MelansonTech/Speaker-Module/Photos/20240408_120147.jpg

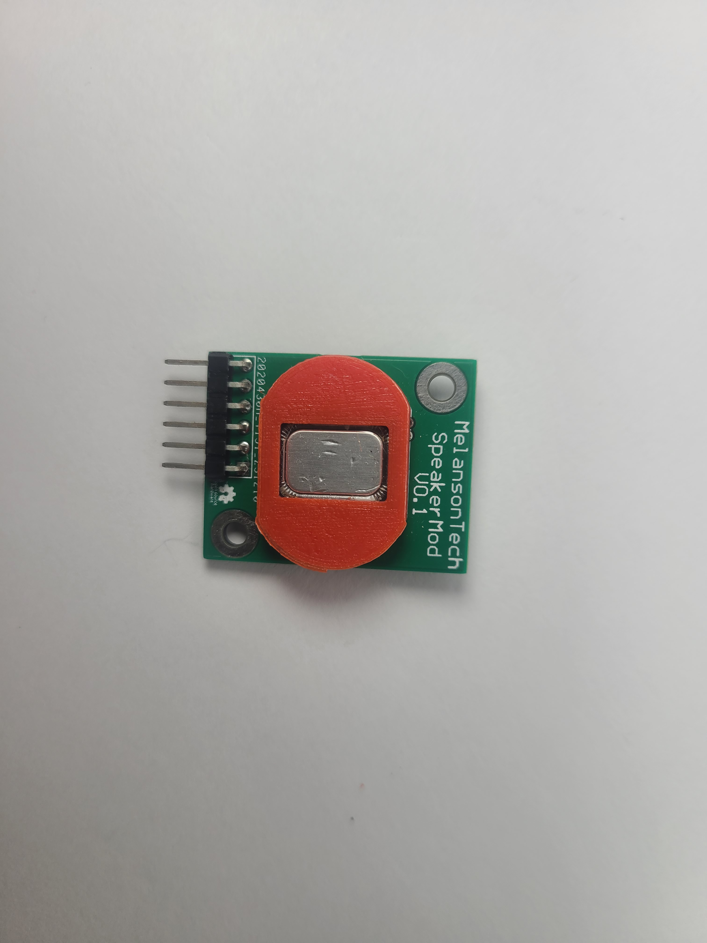
Photos/20240408_120147.jpg
