MelansonTech/Speaker-Module/Photos/20240408_120144.jpg

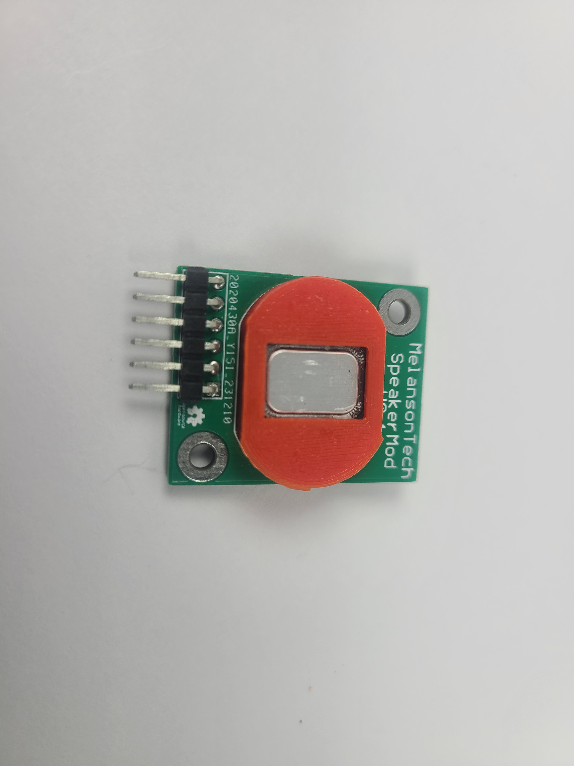
Photos/20240408_120144.jpg
