MelansonTech/Speaker-Module/Project description for speaker module.docx

### Project Title: Mini Speaker Module with IS31AP4991A Audio Driver

#### Overview:

Developed a compact 700mW mini speaker module featuring the CMS-15113-076S speaker and integrated audio driver IS31AP4991A-GRLS2-TR. The project aimed to deliver high-quality audio output in a small form factor with a focus on power efficiency.

#### Project Objectives:

1. Objective 1: Design a mini speaker module with a power output of 700mW.
2. Objective 2: Integrate the CMS-15113-076S speaker for optimal audio performance.
3. Objective 3: Implement the IS31AP4991A-GRLS2-TR audio driver with a gain of 2 and shutdown functionality.
4. Objective 4: Achieve compact dimensions of 33mm by 26mm for the entire module.

#### Role and Responsibilities:

As the lead hardware designer:

- Conducted a comprehensive market analysis to select the CMS-15113-076S speaker and IS31AP4991A-GRLS2-TR audio driver.
- Developed the schematic design using Circuit Studio, considering power requirements, speaker specifications, and audio driver features.
- Utilized LTspice for circuit analysis during the design phase.
- Oversaw the prototyping phase, addressing challenges in component placement and optimizing the layout for the compact form factor.
- Implemented rigorous testing procedures to ensure the module met power output specifications and delivered clear audio signals.

#### Design Process:

1. Conceptualization: Started with a detailed analysis of speaker and audio driver options, considering power requirements and form factor constraints.
2. Schematic Design: Developed a schematic using Circuit Studio, integrating the CMS-15113-076S speaker and IS31AP4991A-GRLS2-TR audio driver with a focus on efficient power utilization.
3. Prototyping: Executed multiple prototypes, refining the layout for optimal signal integrity and minimizing interference.
4. Testing and Validation: Conducted extensive testing to verify the 700mW power output, audio quality, and shutdown functionality of the module.

#### Key Features:

1. High Power Output: Achieved a 700mW power output for clear and loud audio playback.
2. Compact Form Factor: Designed the module with dimensions of 33mm by 26mm, making it suitable for space-constrained applications.
3. Integrated Audio Driver: Utilized the IS31AP4991A-GRLS2-TR audio driver with a gain of 2 and shutdown functionality for efficient power management.

#### Tools and Technologies:

1. Design Software: Utilized Circuit Studio for schematic design and layout.
2. Simulation Software: Employed LTspice for circuit analysis.
3. Testing Equipment: Used oscilloscope and multimeter for signal verification and power measurements.

#### Results and Achievements:

The mini speaker module successfully met and exceeded the project objectives, delivering a powerful audio output in a compact form factor. The integrated audio driver ensured efficient power management, and the module proved to be reliable and robust in various testing scenarios.

#### Lessons Learned:

The project provided valuable insights into optimizing component placement for compact designs and balancing power efficiency with audio performance. Future iterations could explore additional features while maintaining the small footprint.

#### Conclusion:

The completion of the mini speaker module project demonstrates a successful integration of the CMS-15113-076S speaker and IS31AP4991A-GRLS2-TR audio driver, showcasing expertise in hardware design, compact layout, and power management.

#### Additional Resources:

- Link to Datasheet: CMS-15113-076S Speaker
- Link to Datasheet: IS31AP4991A-GRLS2-TR Audio Driver
