MelansonTech/Speaker-Module/Photos/20240408_120136.jpg

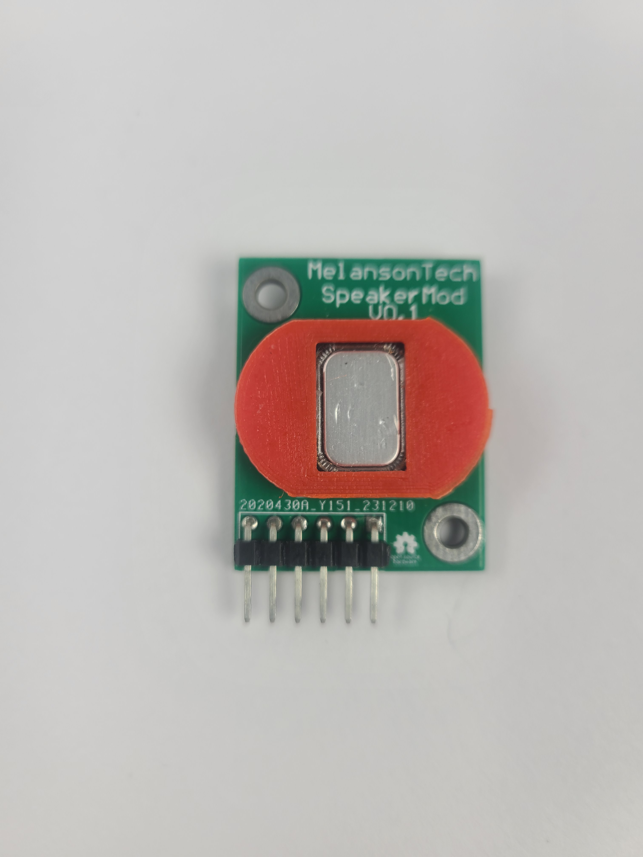
Photos/20240408_120136.jpg
