MelansonTech/Speaker-Module/Photos/20240408_120201.jpg

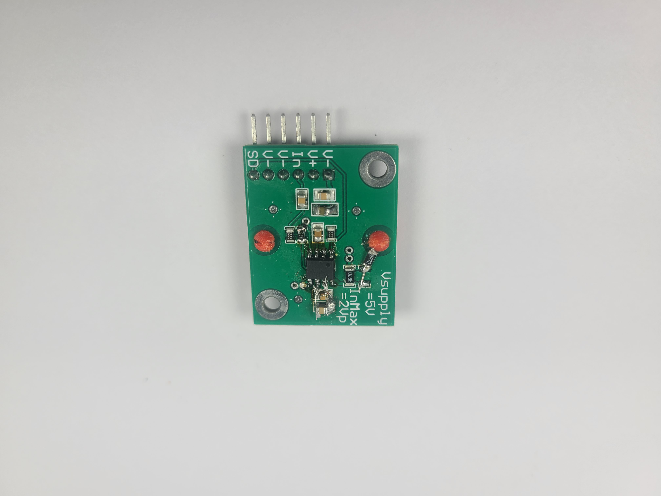
Photos/20240408_120201.jpg
