MelansonTech/Speaker-Module/Default Configuration/Outputs/BOM/BOM_PartType-Speaker Module Rev 2.xls

Sheet: BOM Report
Bill of Materials |  |  | <Parameter Title not found>
Source Data From: |  | Speaker Module Rev 2.PrjPcb
Project: |  | Speaker Module Rev 2.PrjPcb
Variant: |  | None
Creation Date: | 12/27/2023 | 3:08:30 PM
Print Date: | 2023-12-27 | 15:08:53
Production Quantity: | 1
Currency | CAD
Footprint | Comment | LibRef | Designator | Description | Quantity | Supplier 1 | Supplier Part Number 1 | Supplier Unit Price 1 | Supplier Order Qty 1 | Supplier Subtotal 1 | Manufacturer 1 | Manufacturer Part Number 1
Cap,0805 | 08055C104JAT2A | Cap,0805,100nf,50V,5%,08055C104JAT2A | C1, C4, C5 | Capacitor; Ceramic; Cap 0.1 uF; Tol 5%; Vol-Rtg 50 VDC; SMT; 0805; X7R; Tape & Reel | 3 | Digi-Key | 478-3352-1-ND |  |  |  | Loading... | Loading...
CAP, 0805, HD | AVX 08053C225KAT2A | Cap,0805,2.2uF,±10%,25V,08053C225KAT2A | C2 | 0805 2.2 uF 25 V ±10 % Tolerance X7R SMT Multilayer Ceramic Capacitor | 1 | Digi-Key | 478-5719-1-ND |  |  |  | Kyocera AVX | KGM21AR71E225KU
Cap,0805 | CGA4J2X7R1E474K125AA | Cap,0805,470nf,25V,10%,CGA4J2X7R1E474K125AA | C3 | 0.47µF ±10% 25V Ceramic Capacitor X7R 0805 (2012 Metric) | 1 | Digi-Key | 445-5685-1-ND | 0.3052 | 1 | $0.31 | TDK | CGA4J2X7R1E474K125AA
Cap, 1206 | C3216X7R1E106K160AB | CAP,1206,10uF,25V,C3216X7R1E106K160AB | C6 | 10µF ±10% 25V Ceramic Capacitor X7R 1206 (3216 Metric) | 1 | Digi-Key | 445-7705-1-ND |  |  |  | Loading... | Loading...
FIDU-ROUND | Mech,FIDU-ROUND | Mech,FIDU-ROUND | FD1, FD2, FD3 | ROUND FIDUCIAL | 3
Header, 6 pin, 0.1" Spaceing - RA | Header, through hole,vertical, 6pin,1 Row,0.1", M20-9991245 | Header, through hole,vertical, 6pin,1 Row,0.1", M20-9991245 | J1 | 2.54mm (0.1") Pitch SIL Vertical PC Tail Pin Header, 6.1mm mating pin height, gold (hi-temp mould), 6 contacts | 1 | Digi-Key
Symbol,Open Source | Open Source Logo | Symbol,Open Source | Logo1 | Open Source Silk Screen Logo | 1
Standoff,Hex,M3,8mm | M3 hex Standoff | Mech,Standoff, M3, Hex | M1, M2 | HEX STANDOFF M3,generic | 2 | Digi-Key | 36-24314-ND | 1.34797 | 2 | $2.70 | Keystone Electronics | 24314
res, 0805, HD | RC0805FR-0722K1L | Res,0805,22.1K,1%,100ppm,RC0805FR-0722K1L | R1, R4 | 22.1 kOhms ±1% 0.125W, 1/8W Chip Resistor 0805 (2012 Metric) Moisture Resistant Thick Film | 2 | Digi-Key | 311-22.1KCRCT-ND | 0.12717 | 2 | $0.25 | Yageo | RC0805FR-0722K1L
Res,1206 | 4.7O | Res,1206,Generic | R2, R3 |  | 2
res, 0805, HD | RK73H2ATTD4752F | Res,0805,47.5KO,1%,100ppm,RK73H2ATTD4752F | R5 | 47.5 kOhms ±1% 0.25W, 1/4W Chip Resistor 0805 (2012 Metric) Automotive AEC-Q200, Moisture Resistant Thick Film | 1 | Digi-Key | 2019-RK73H2ATTD4752FCT-ND | 0.12717 | 1 | $0.13 | KOA Speer | RK73H2ATTD4752F
Speaker,SMD,CMS-15113-076S | CMS-15113-076S | Speaker,SMD,6O,700mW,Magnetic,100 Hz ~ 20 kHz,CMS-15113-076S | Speaker1 | 6 Ohms General Purpose Speaker 700 mW 100 Hz ~ 20 kHz Top Rectangular | 1
SOIC-8 | IS31AP4991A-GRLS2-TR | IC,PowerAmp,ClassAB,1.15W x 1 @ 8Ohm,2.7V ~ 5.5V,IS31AP4991 | U1 | IC AMP CLASS AB MONO 1.15W 8SOIC | 1 | Mouser | 870-I31AP4991AGRLS2T | 0.72485 | 1 | $0.72 | ISSI | IS31AP4991A-GRLS2-TR
 |  |  |  |  | 20 |  |  |  |  | $4.11
Approved |  | Notes

Sheet: Project Information
Project Full Path | E:\OneDrive\Shawn\circuitstudio projects\Speaker Module\Speaker Module Rev 2.PrjPcb
Project Filename | Speaker Module Rev 2.PrjPcb
Variant Name | None
Data-Source Filename | Speaker Module Rev 2.PrjPcb
Data-Source Full Path | E:\OneDrive\Shawn\circuitstudio projects\Speaker Module\Speaker Module Rev 2.PrjPcb
Title | <Parameter Title not found>
Total Quantity | 20
Report Time | 3:08:30 PM
Report Date | 12/27/2023
Report Date & Tine | 12/27/2023 3:08:30 PM
Output Name | BOM_PartType
Output Type | BOM_PartType
Output Generator Name | BOM
Output Generator Description | Bill of Materials
