MelansonTech/Speaker-Module/Default Configuration/Outputs/JLC Order Info/Speaker Module Rev 1_JLC_BOM Rev 1.xlsx

Comment | Designator | Footprint | LCSC Part #（optional）
100nF 0805 | C1, C4, C5 | 0805_C | C49678
Cap,0805,2.2uF,±10%,25V,08053C225KAT2A | C2 | 0805_C | C377773
Cap,0805,470nf,25V,10%,CGA4J2X7R1E474K125AA | C3 | 0805_C | C13967
CAP,1206,10uF,25V,C3216X7R1E106K160AB | C6 | 1206_C | C13585
Res,0805,22.1K,1%,100ppm,RC0805FR-0722K1L | R1, R4, R5 | 0805_R | C17560
