MelansonTech/Speaker-Module/Default Configuration/Outputs/Speaker module Rev 1 Sept 2022/BOM_PartType-Speaker Module.xls

Sheet: BOM Report
Bill of Materials |  |  | <Parameter Title not found>
Source Data From: |  | Speaker Module.PrjPcb
Project: |  | Speaker Module.PrjPcb
Variant: |  | None
Creation Date: | 9/18/2022 | 9:58:10 PM
Print Date: | 2022-09-18 | 21:58:31
Production Quantity: | 1
Currency | CAD
Footprint | Comment | LibRef | Designator | Description | Quantity | Supplier 1 | Supplier Part Number 1 | Supplier Unit Price 1 | Supplier Order Qty 1 | Supplier Subtotal 1 | Manufacturer 1 | Manufacturer Part Number 1
Cap,0805 | 08055C104JAT2A | Cap,0805,100nf,50V,5%,08055C104JAT2A | C1, C4, C5 | Capacitor; Ceramic; Cap 0.1 uF; Tol 5%; Vol-Rtg 50 VDC; SMT; 0805; X7R; Tape & Reel | 3 | Digi-Key | 478-3352-1-ND | 0.1526 | 3 | $0.46 | Kyocera AVX | 08055C104JAT2A
CAP, 0805, HD | AVX 08053C225KAT2A | Cap,0805,2.2uF,±10%,25V,08053C225KAT2A | C2 | 0805 2.2 uF 25 V ±10 % Tolerance X7R SMT Multilayer Ceramic Capacitor | 1 | Digi-Key | 478-5719-1-ND | 0.3815 | 1 | $0.38 | Kyocera AVX | 08053C225KAT2A
Cap,0805 | CGA4J2X7R1E474K125AA | Cap,0805,470nf,25V,10%,CGA4J2X7R1E474K125AA | C3 | 0.47µF ±10% 25V Ceramic Capacitor X7R 0805 (2012 Metric) | 1 | Digi-Key | 445-5685-1-ND | 0.3052 | 1 | $0.31 | TDK | CGA4J2X7R1E474K125AA
Cap, 1206 | C3216X7R1E106K160AB | CAP,1206,10uF,25V,C3216X7R1E106K160AB | C6 | 10µF ±10% 25V Ceramic Capacitor X7R 1206 (3216 Metric) | 1 | Digi-Key | 445-7705-1-ND |  |  |  | TDK | C3216X7R1E106K160AB
FIDU-ROUND | Mech,FIDU-ROUND | Mech,FIDU-ROUND | FD1, FD2, FD3 | ROUND FIDUCIAL | 3
Header, 6 pin, 0.1" Spaceing - RA | Header, through hole,vertical, 6pin,1 Row,0.1", M20-9991245 | Header, through hole,vertical, 6pin,1 Row,0.1", M20-9991245 | J1 | 2.54mm (0.1") Pitch SIL Vertical PC Tail Pin Header, 6.1mm mating pin height, gold (hi-temp mould), 6 contacts | 1 | Digi-Key
Symbol,Open Source | Open Source Logo | Symbol,Open Source | Logo1 | Open Source Silk Screen Logo | 1
Standoff,Hex,M3,8mm | M3 hex Standoff | Mech,Standoff, M3, Hex | M1, M2 | HEX STANDOFF M3,generic | 2 | Digi-Key | 36-24314-ND | 1.41155 | 2 | $2.82 | Keystone Electronics | 24314
res, 0805, HD | RC0805FR-0722K1L | Res,0805,22.1K,1%,100ppm,RC0805FR-0722K1L | R1, R4, R5 | 22.1 kOhms ±1% 0.125W, 1/8W Chip Resistor 0805 (2012 Metric) Moisture Resistant Thick Film | 3 | Digi-Key | 311-22.1KCRCT-ND | 0.12717 | 3 | $0.38 | Yageo | RC0805FR-0722K1L
Res,1206 | 4.7O | Res,1206,Generic | R2, R3 |  | 2
Speaker,SMD,CMS-15113-076S | CMS-15113-076S | Speaker,SMD,6O,700mW,Magnetic,100 Hz ~ 20 kHz,CMS-15113-076S | Speaker1 | 6 Ohms General Purpose Speaker 700 mW 100 Hz ~ 20 kHz Top Rectangular | 1
SOIC-8 | IS31AP4991A-GRLS2-TR | IC,PowerAmp,ClassAB,1.15W x 1 @ 8Ohm,2.7V ~ 5.5V,IS31AP4991 | U1 | IC AMP CLASS AB MONO 1.15W 8SOIC | 1 | Mouser | 870-I31AP4991AGRLS2T | 0.95375 | 1 | $0.95 | ISSI | IS31AP4991A-GRLS2-TR
 |  |  |  |  | 20 |  |  |  |  | $5.30
Approved |  | Notes

Sheet: Project Information
Project Full Path | E:\OneDrive\Shawn\circuitstudio projects\Speaker Module\Speaker Module.PrjPcb
Project Filename | Speaker Module.PrjPcb
Variant Name | None
Data-Source Filename | Speaker Module.PrjPcb
Data-Source Full Path | E:\OneDrive\Shawn\circuitstudio projects\Speaker Module\Speaker Module.PrjPcb
Title | <Parameter Title not found>
Total Quantity | 20
Report Time | 9:58:10 PM
Report Date | 9/18/2022
Report Date & Tine | 9/18/2022 9:58:10 PM
Output Name | BOM_PartType
Output Type | BOM_PartType
Output Generator Name | BOM
Output Generator Description | Bill of Materials
