MelansonTech/Speaker-Module/3d Models/Speaker Retainer cone v3- Tighter fit.stl

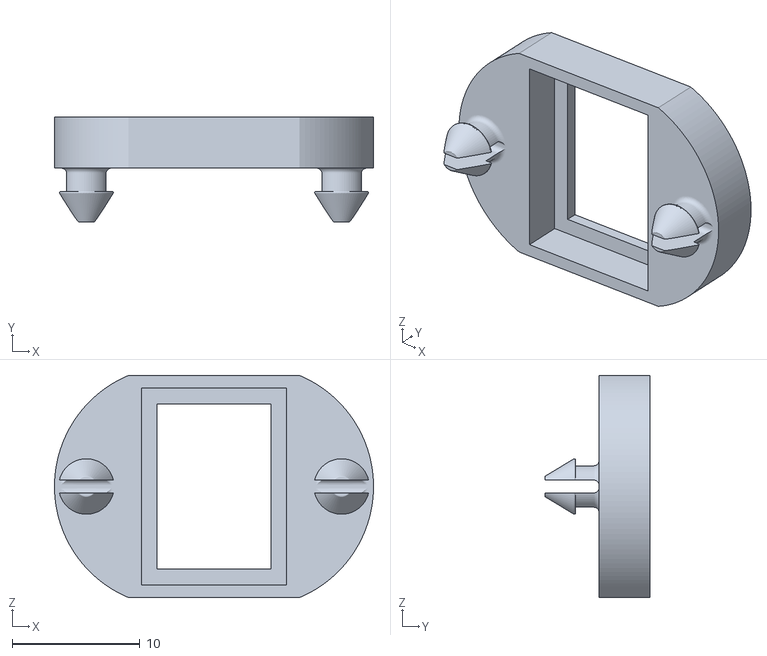
[picture p5: CAD file, 2025-01-01]
3d Models/Speaker Retainer cone v3- Tighter fit.stl
25.0 x 8.24 x 17.4
