MelansonTech/Speaker-Module/Default Configuration/Outputs/ExportSTEP/Speaker Module Rev 2.step

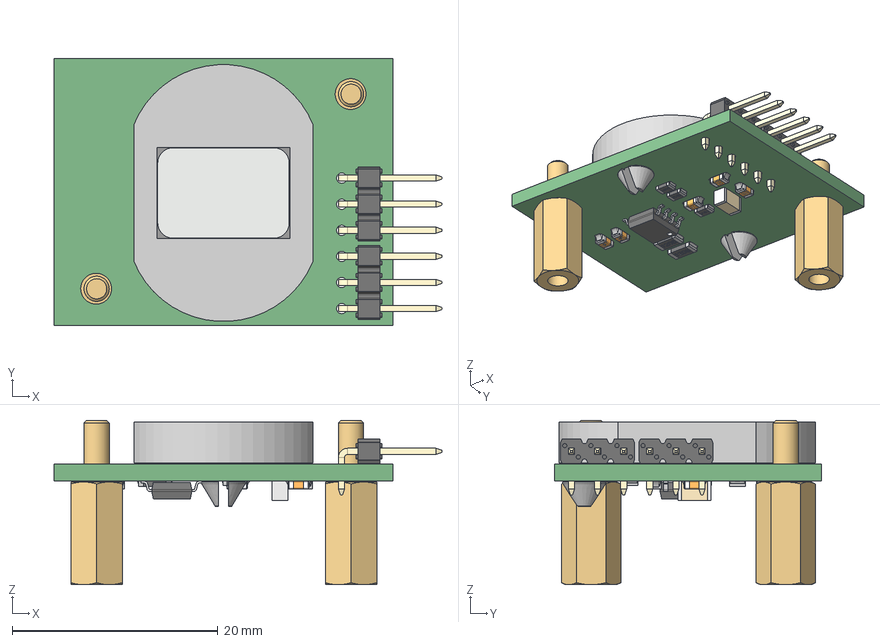
[picture p6: CAD file, 2025-01-01]
Default Configuration/Outputs/ExportSTEP/Speaker Module Rev 2.step
37.8 x 26.0 x 16.0 mm
Board
User_Library-0805_Cap x 5
Extruded x 3
3_pin_RA_100mil_header_v1 x 2
Distans_Erkek_M3x10mm_YP-510 x 2
0805_Resistor_v11 x 3
1206_Resistor_v12 x 2
CUI_DEVICES_CMS-15113-076S_v1
User_Library-SOIC-8-1
