MelansonTech/Speaker-Module/3d Models/CUI_DEVICES_CMS-15113-076S.step

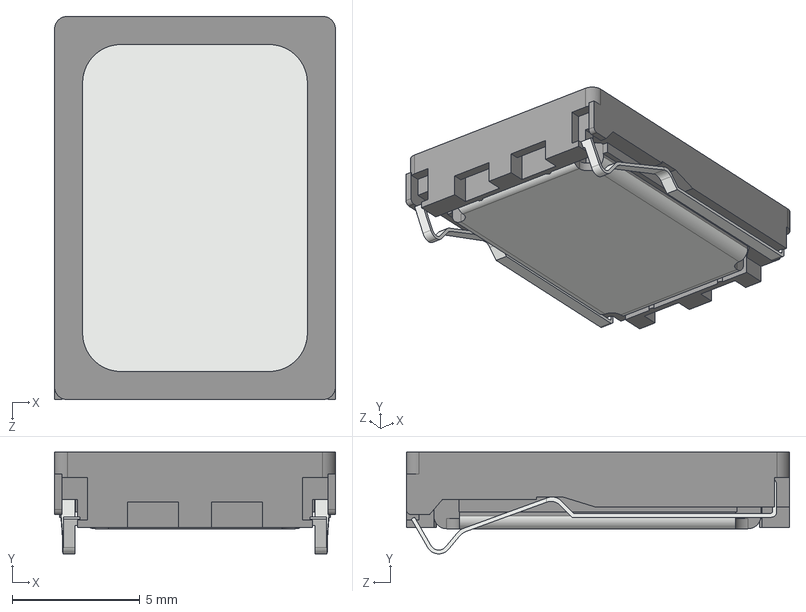
[picture p7: CAD file, 2025-01-01]
3d Models/CUI_DEVICES_CMS-15113-076S.step
11.0 x 3.98 x 15.0 mm
