MelansonTech/Speaker-Module/3d Models/Speaker Retainer Version 3 v2.step

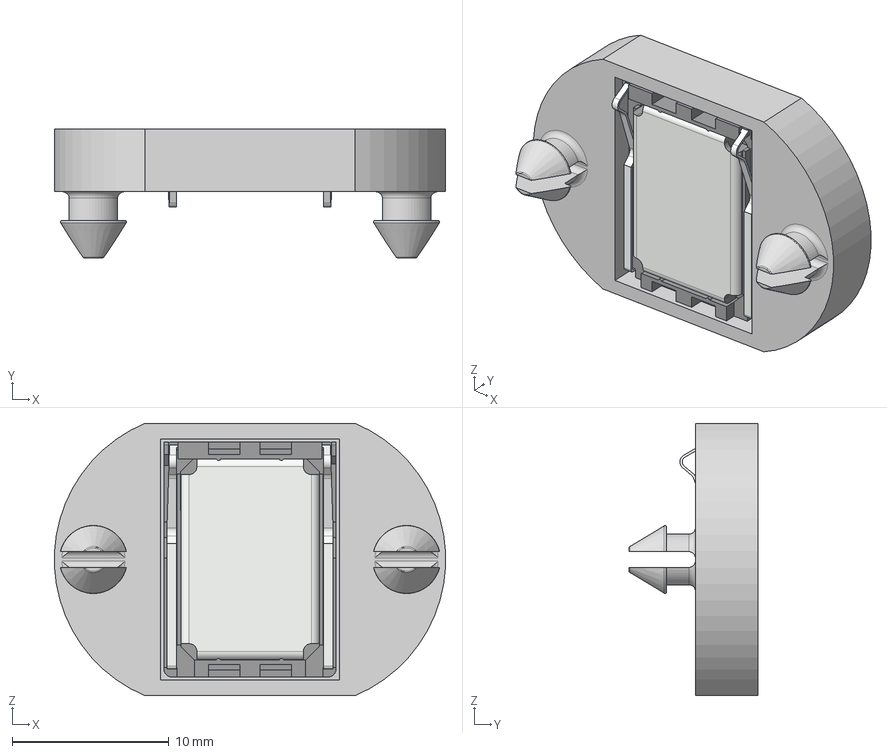
[picture p8: CAD file, 2025-01-01]
3d Models/Speaker Retainer Version 3 v2.step
25.0 x 8.23 x 17.4 mm
