MelansonTech/Speaker-Module/3d Models/Speaker Retainer cone v4.stl

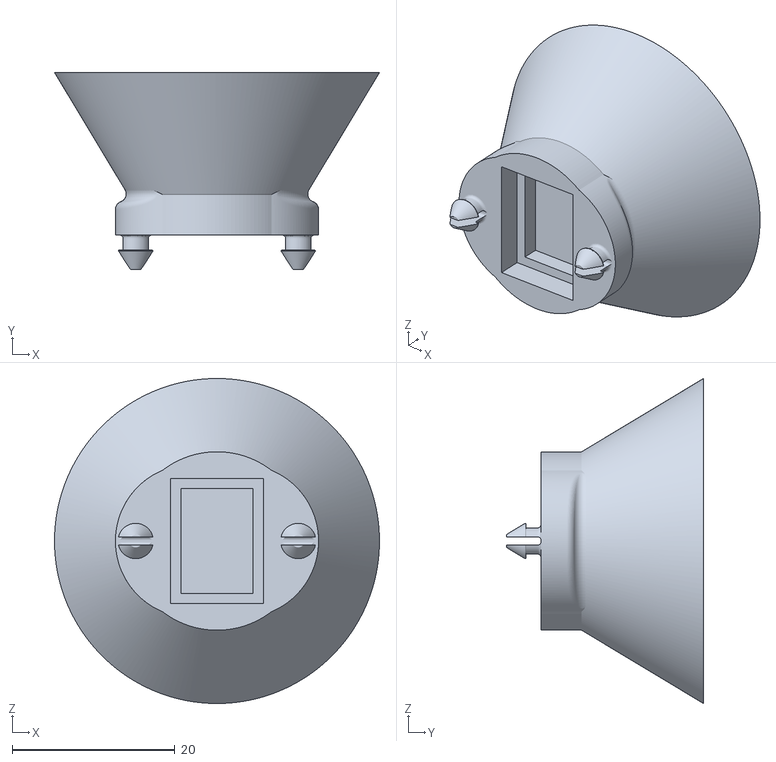
[picture p9: CAD file, 2025-01-01]
3d Models/Speaker Retainer cone v4.stl
40.0 x 24.2 x 40.0
