MelansonTech/Speaker-Module/3d Models/Speaker Retainer Version 4 v1.step

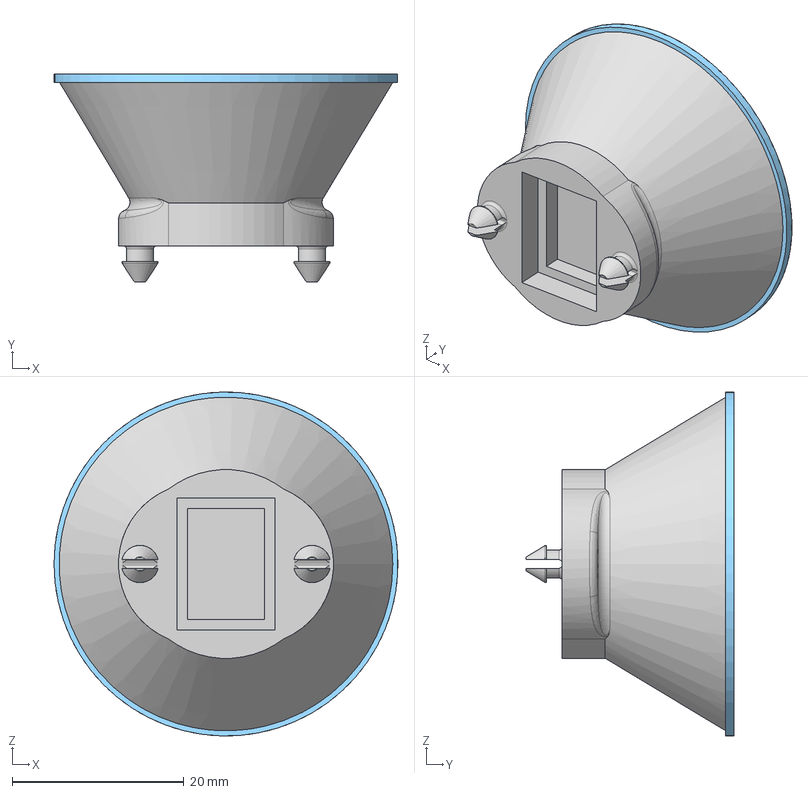
[picture p10: CAD file, 2025-01-01]
3d Models/Speaker Retainer Version 4 v1.step
40.0 x 24.2 x 40.0 mm
