MelansonTech/Speaker-Module/3d Models/Speaker Retainer.3mf

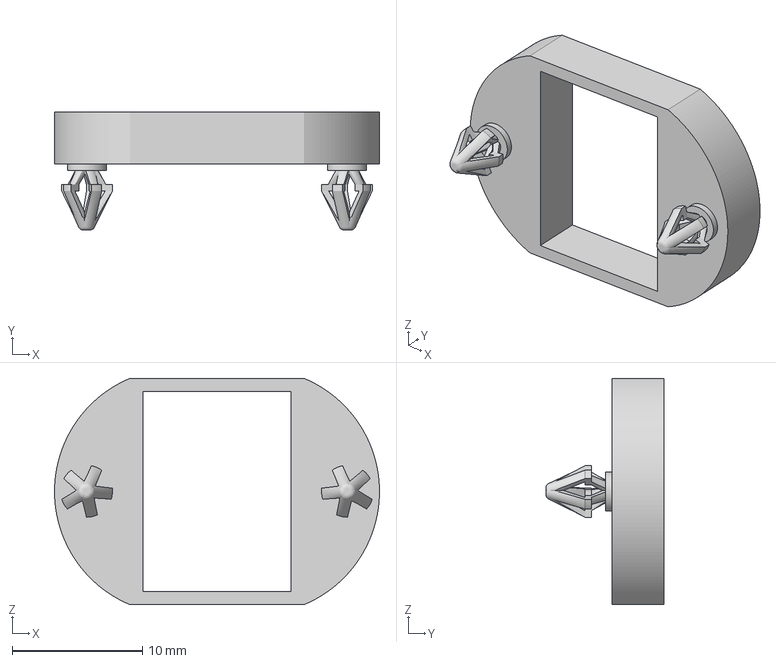
[picture p11: CAD file, 2025-01-01]
3d Models/Speaker Retainer.3mf
25.0 x 9.10 x 17.4 mm
