MelansonTech/Speaker-Module/(list of files, cad)

Other CAD files:
3d Models/Speaker Retainer v3.3mf
