MelansonTech/Speaker-Module/Default Configuration/Outputs/Speaker Module.PDF

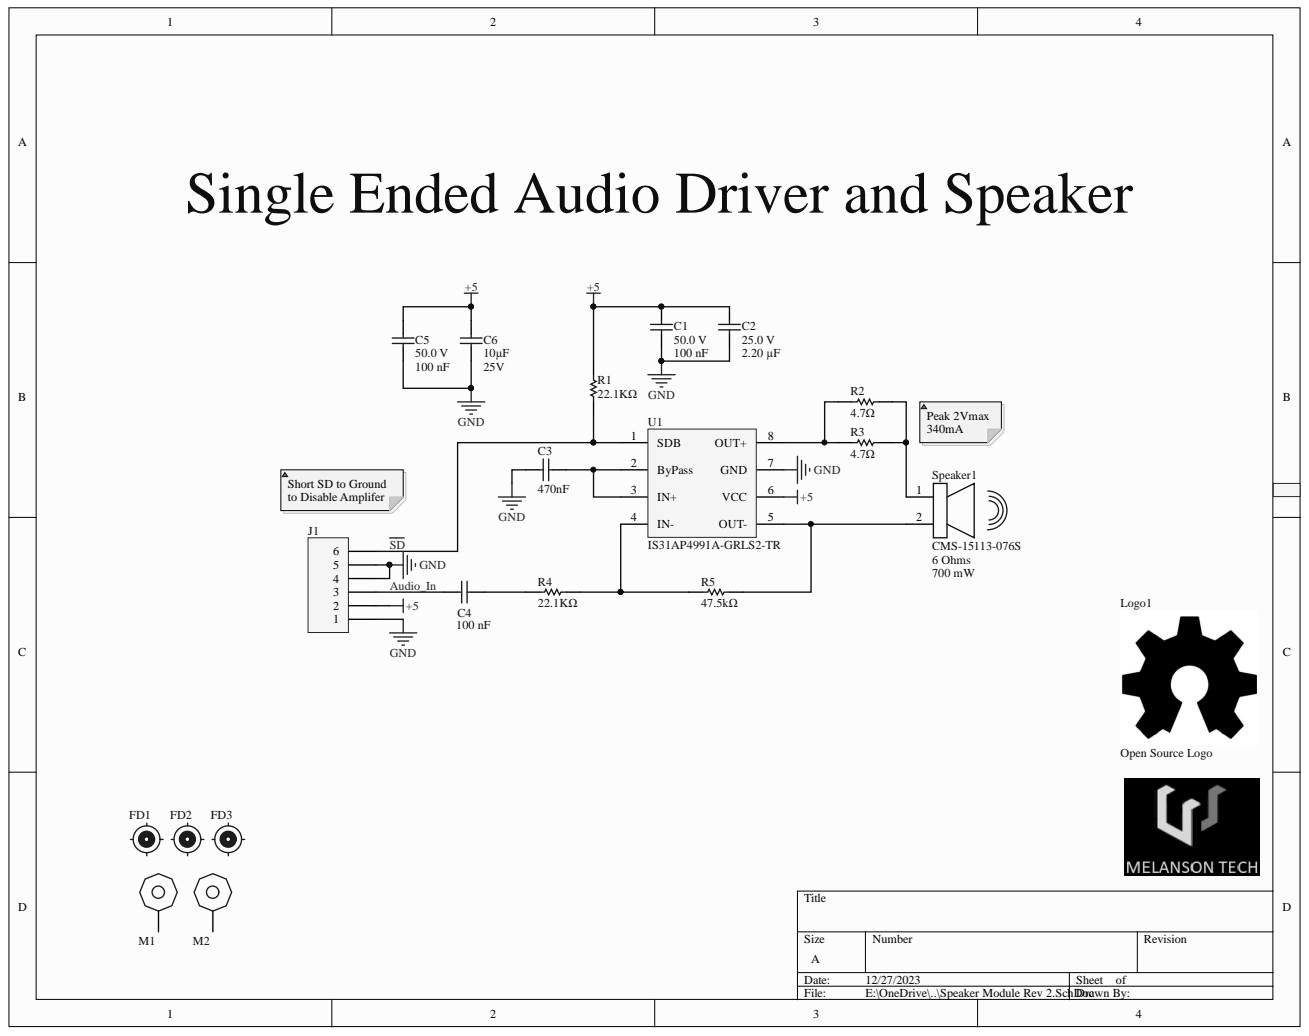
[picture p12: page 1]

Single Ended Audio Driver and Speaker

Short SD to Ground
to Disable Amplifer

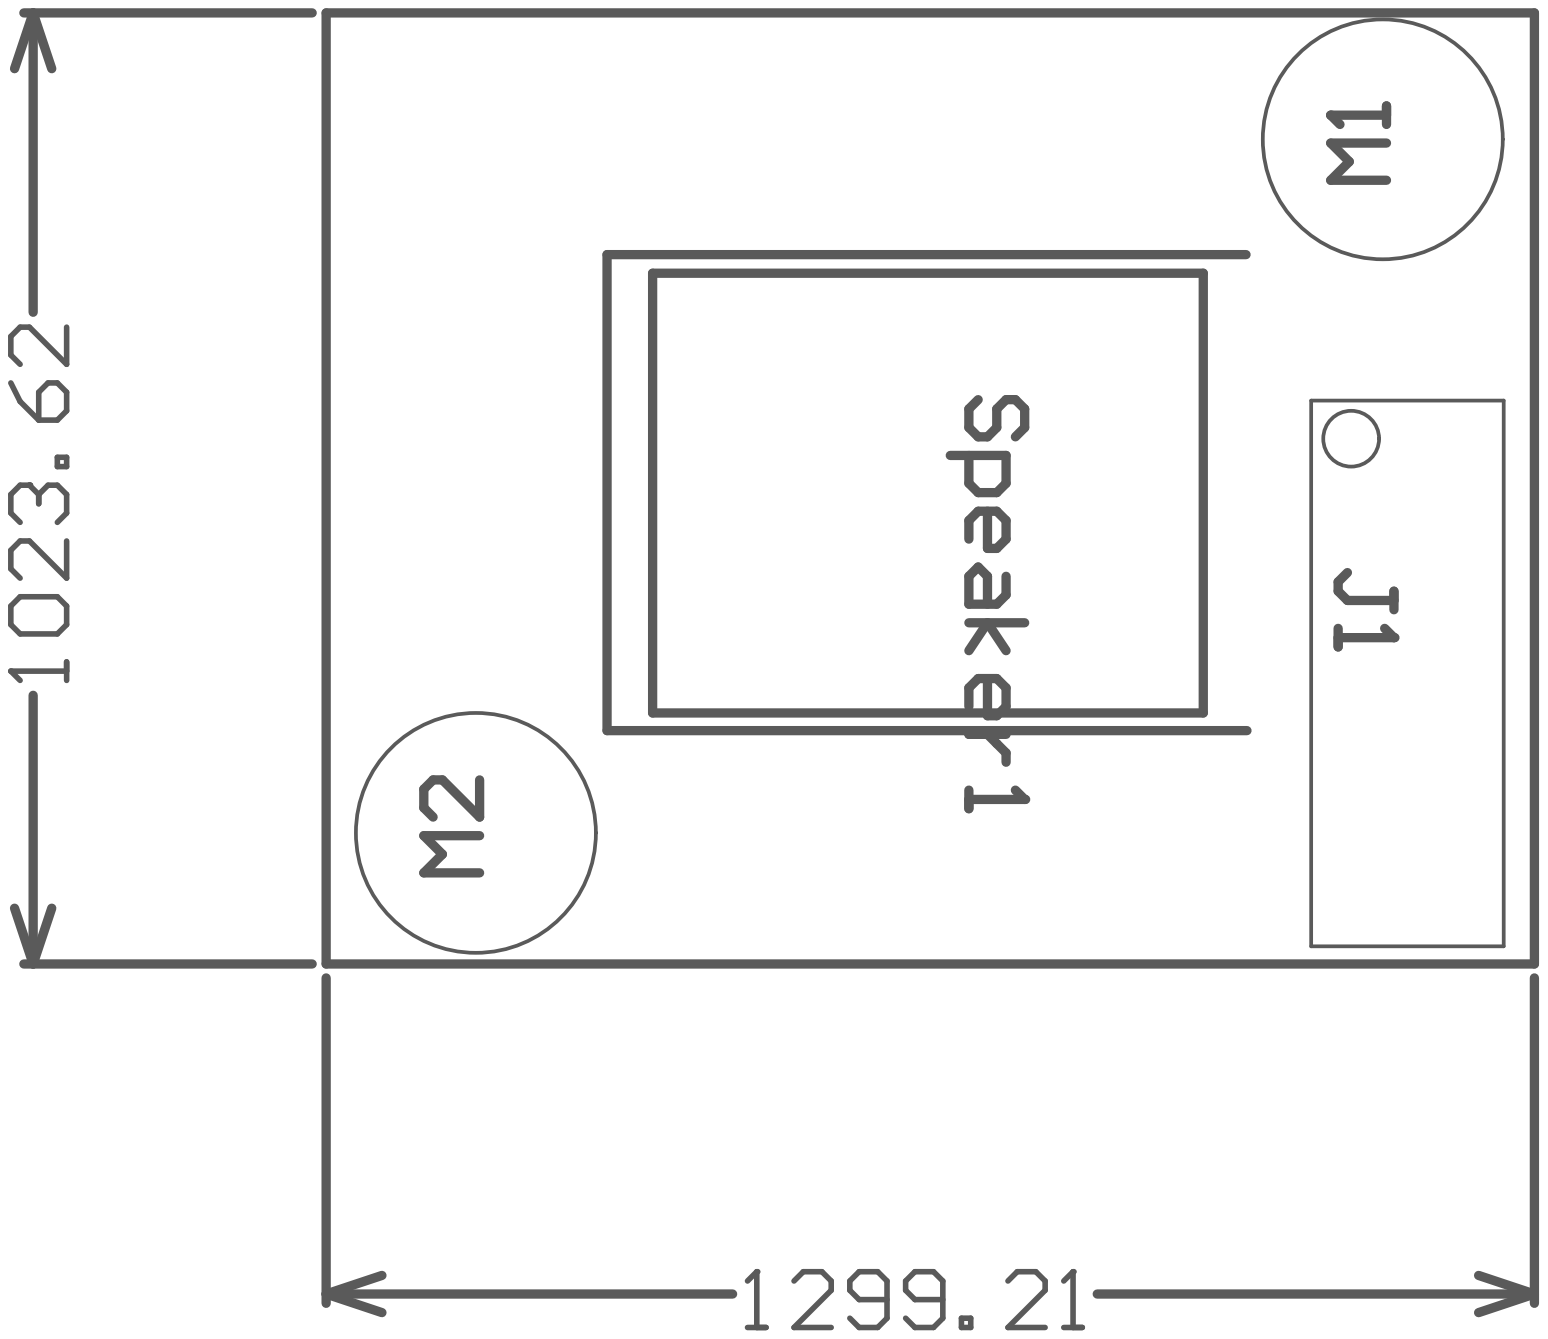
[picture p13: page 2]

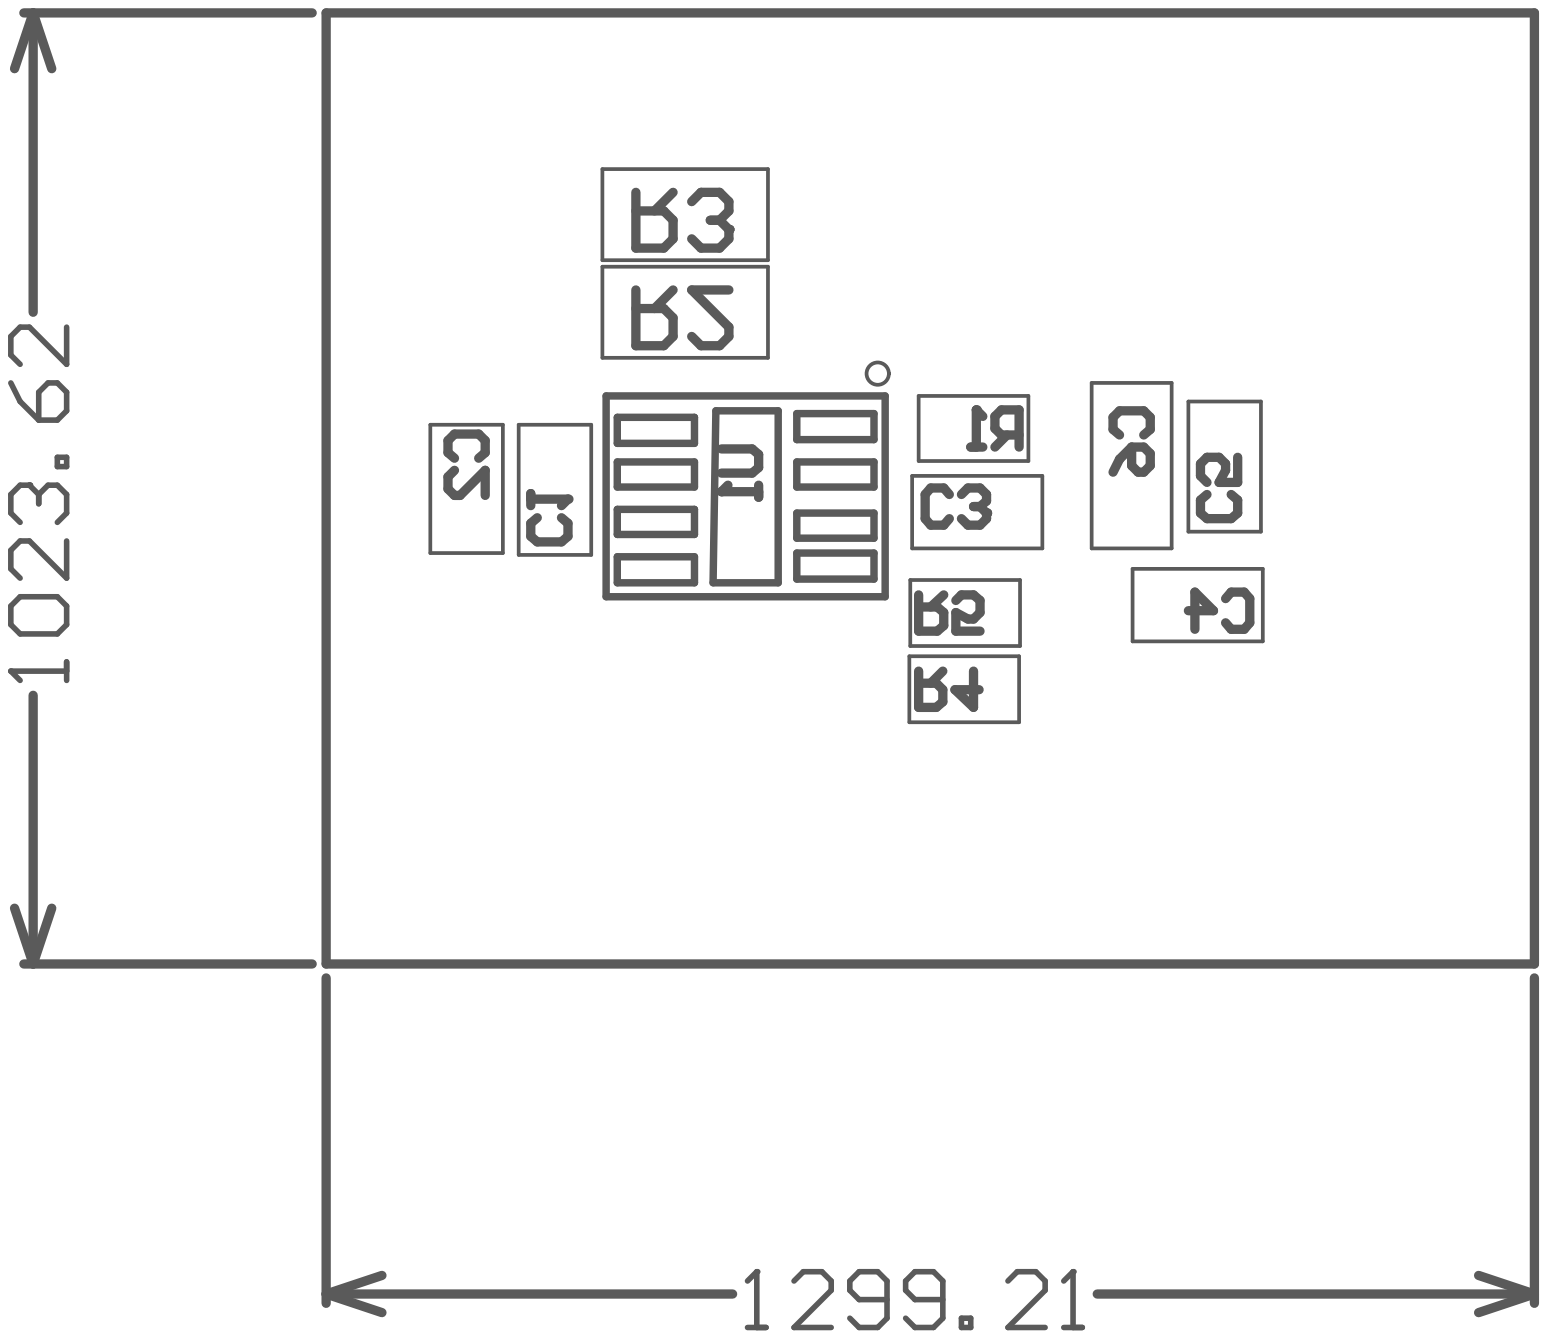
[picture p14: page 3]

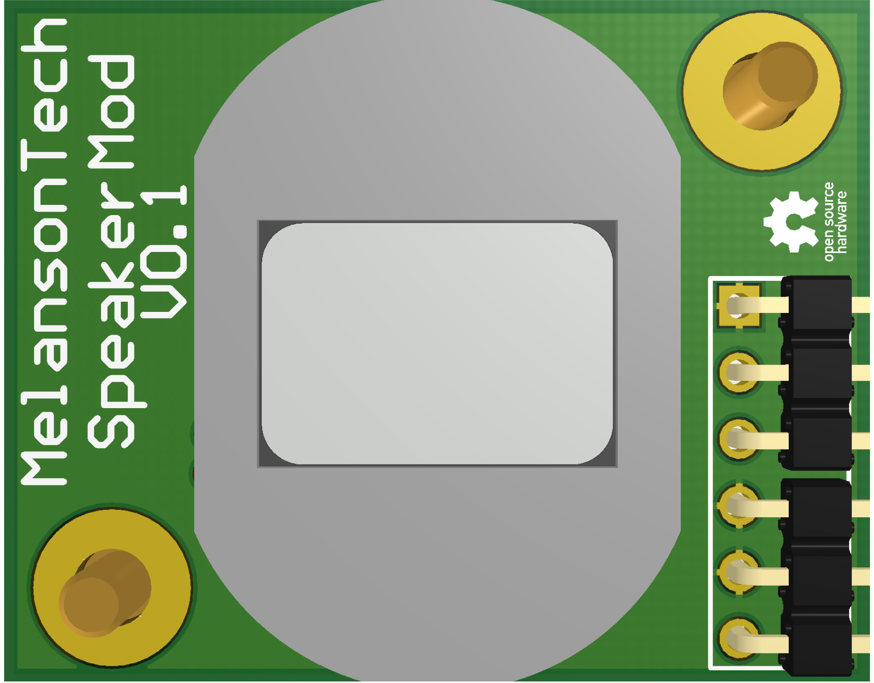
[picture p15: page 4]
