MelansonTech/Speaker-Module/(list of files, drawings)

Other design files:
Speaker Module Rev 2.PrjPcb
Speaker Module Rev 2.SchDoc
Speaker Module.PrjPcb
Speaker Module.SchDoc
